Cisco-Offensive-Summit/badge-2026/hardware/readme.md

## 2026 Offensive Summit Badge hardware files

[PCB Schematic](https://github.com/Cisco-Offensive-Summit/badge-2026/blob/main/hardware/OS-2026-Badge-Schematic-REV1.pdf)  
[PCB Assembly Document](https://github.com/Cisco-Offensive-Summit/badge-2026/blob/main/hardware/2026-Badge-Assembly-REV1.PDF)   
[PCB Fabrication Drawing](https://github.com/Cisco-Offensive-Summit/badge-2026/blob/main/hardware/2026-Badge-Fabdrawing-REV1.PDF)  

[PCB Bill of Materials](https://github.com/Cisco-Offensive-Summit/badge-2026/blob/main/hardware/2026-Badge-BOM-REV1.xls)  
[Final Assembly Bill of Materials](https://github.com/Cisco-Offensive-Summit/badge-2026/blob/main/hardware/2026-Badge-Final-Assembly-BOM.xlsx)  

[PCB Fabrication Data](https://github.com/Cisco-Offensive-Summit/badge-2026/blob/main/hardware/2026-Badge-REV1.zip)   

[2D Front Side Image](https://github.com/Cisco-Offensive-Summit/badge-2026/blob/main/hardware/2026-Badge-2D-Front.PNG)  
[2D Back Side Image](https://github.com/Cisco-Offensive-Summit/badge-2026/blob/main/hardware/2026-Badge-2D-Back.PNG)  

[3D Front Side Image](https://github.com/Cisco-Offensive-Summit/badge-2026/blob/main/hardware/2026-Badge-3D-Front.PNG)  
[3D Back Side Image](https://github.com/Cisco-Offensive-Summit/badge-2026/blob/main/hardware/2026-Badge-3D-Back.PNG)  

[Assembled PCB Front Side Photo](https://github.com/Cisco-Offensive-Summit/badge-2026/blob/main/hardware/os-badge-2026-front-assembled.png)  
[Assembled PCB Back Side Photo](https://github.com/Cisco-Offensive-Summit/badge-2026/blob/main/hardware/os-badge-2026-back-assembled.png)  

## Screens
[P3 E2271KSOC1 ePaper 2.71" TFT EPD](https://www.mouser.in/en/ProductDetail/Pervasive-Displays/E2271KS0C1?qs=ZcfC38r4PouNwoyWKev%252BKw%3D%3D)  
[P2 TFT RGB 1.44"](https://www.digikey.in/en/products/detail/orient-display/AFL128128A0-1-44N12NTM-ANO/22531958)  

## Addressable LEDs
[Neopixel LED D5,D6,D7,D8](https://www.digikey.in/en/products/detail/adafruit-industries-llc/1938/6827082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)
