Cisco-Offensive-Summit/badge-2026/arduino/readme.md

Setup of Arduino Environment:  
Arduino --> Settings --> Additional boards manager URLs: https://espressif.github.io/arduino-esp32/package_esp32_index.json  
Tools --> Board --> Boards Manager --> esp32 by Espressif Systems (install)  
Tools --> Board --> esp32 --> ESP32S3 DEV Module   
Port: "/dev/cu.usbmodemXXXXX"  
USB CDC On Boot: Enabled  
CPU Frequency "240MHz (WiFi)"  
Core Debug Level: "Warn"  
USB DFU On Boot: "Disabled"  
Erase All Flash Before Sketch Upload: "Enabled"  
Events Run On: "Core 1"  
Flash Mode: "QIO 80MHz"  
Flash Size: "16MB (128Mb)"  
JTAG Adapter: "Disabled"  
Arduino Runs On: "Core 1"  
USB Firmware MSC On Boot: "Disabled"  
Partition Scheme: "Minimal(1.3MB APP/700KB SPIFFS)"  
PSRAM: "Disabled"  
Upload Mode: "UART0/Hardware CDC"  
Upload Speed "115200"  
USB Mode "Hardware CDC and JTAG"  
Zigbee Mode: "Disabled"  
Programmer "Esptool"  

Be sure to install the Libraries!!! 
(Tools --> Manage Libraries --> )
Adafruit_BusIO  
Adafruit_ST7735_and_ST7789_Library  
FastLED  
Adafruit_GFX_Library  
PDLS_BASIC  
PDLS_Common  
Pervasive_Wide_Small
