Cisco-Offensive-Summit/badge-2026/docs/HW-VIllage-2026-Presentation.pdf

## HARDWARE VILLAGE 2026

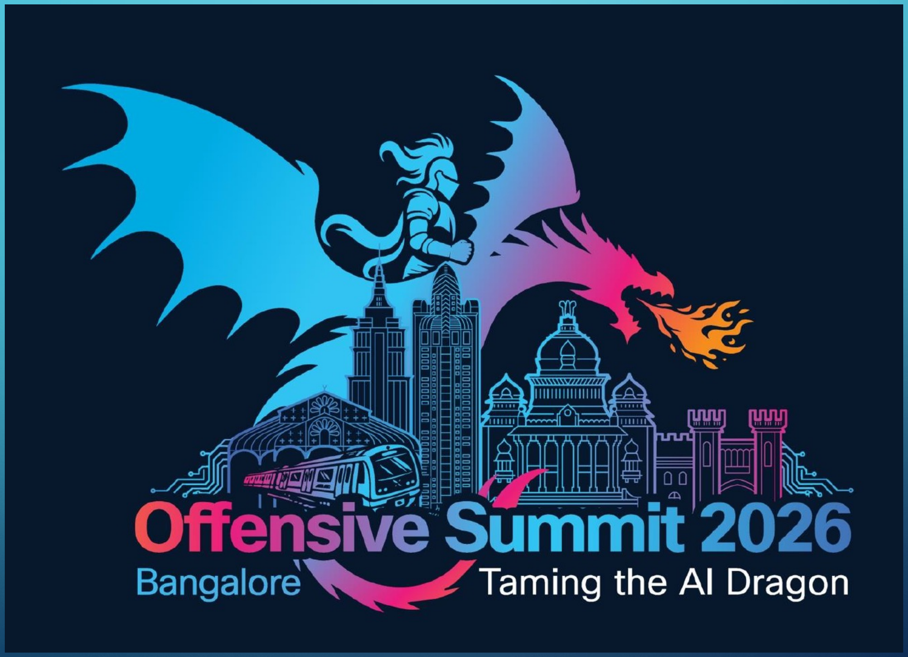
[picture p1: figure]

## OFFENSIVE SUMMIT BADGE 2026

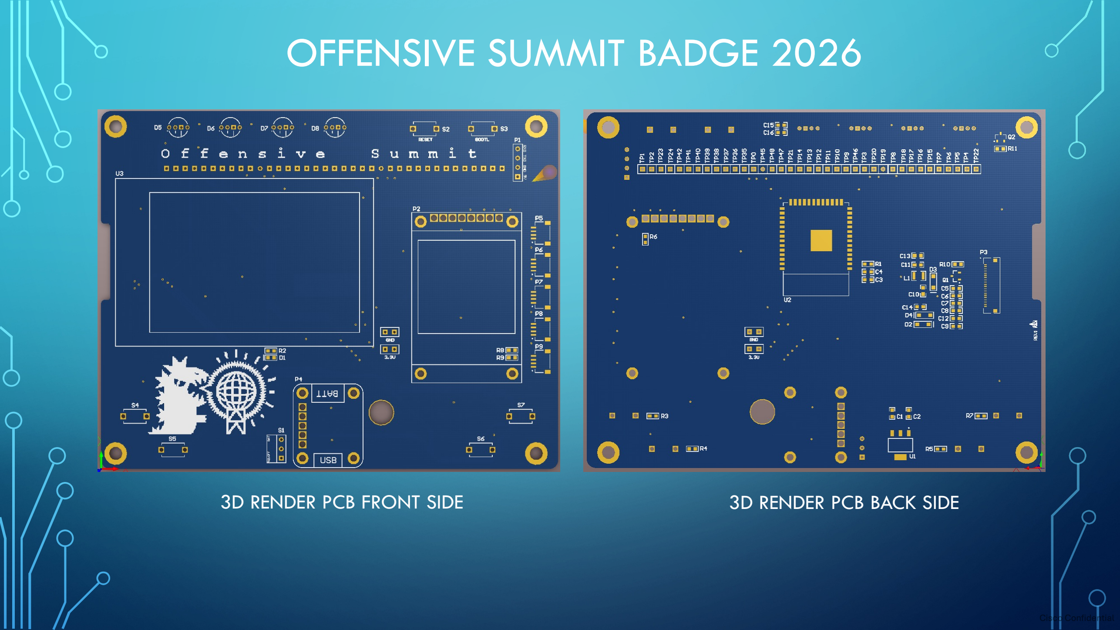
[picture p2: page 2]

3D RENDER PCB FRONT SIDE | 3D RENDER PCB BACK SIDE

## OFFENSIVE SUMMIT BADGE 2026

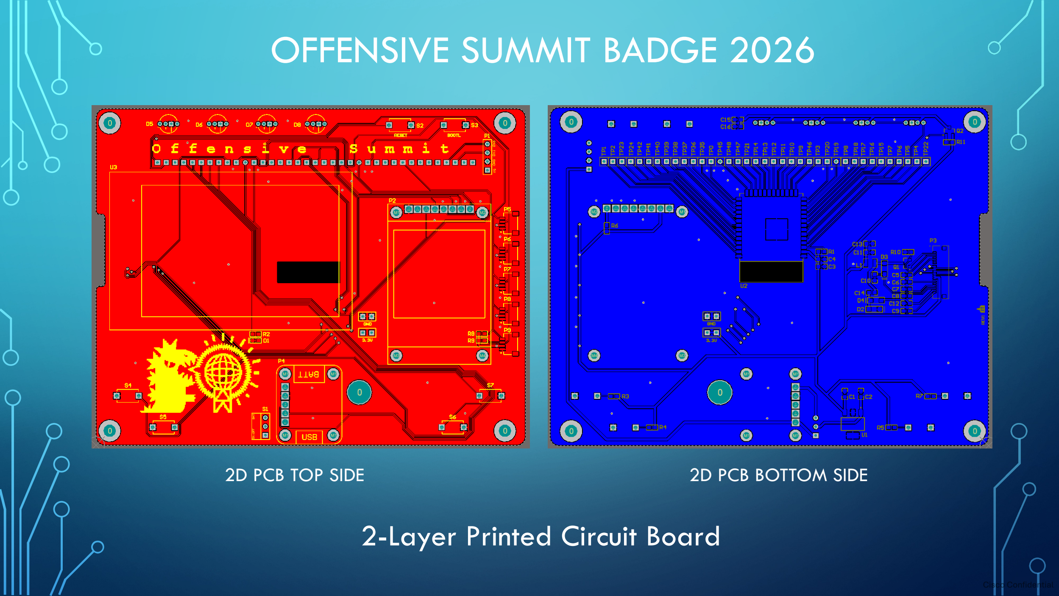
[picture p3: page 3]

2D PCB TOP SIDE | 2D PCB BOTTOM SIDE
2-Layer Printed Circuit Board

## OFFENSIVE SUMMIT BADGE 2026

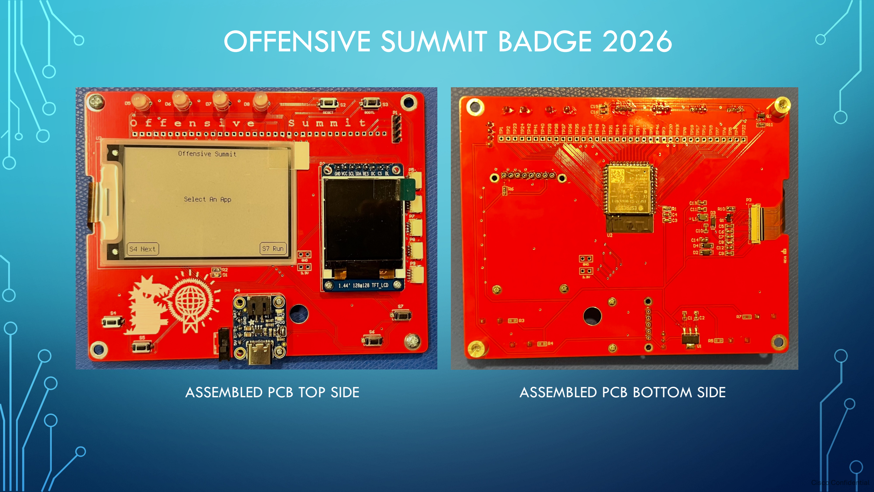
[picture p4: page 4]

ASSEMBLED PCB TOP SIDE | ASSEMBLED PCB BOTTOM SIDE

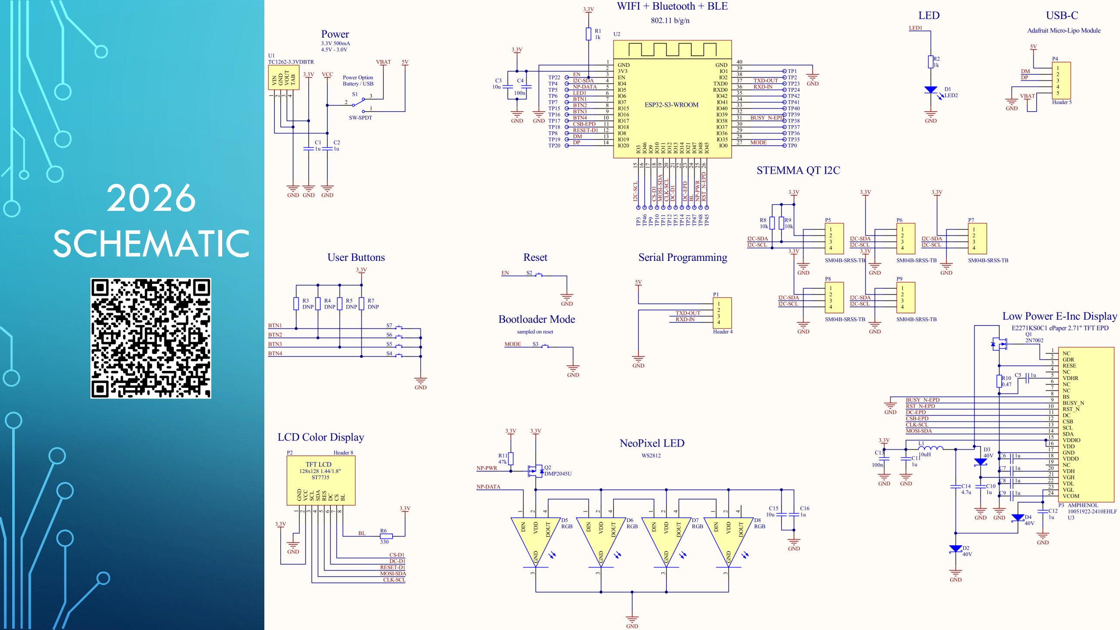
[picture p5: page 5]

2026

## SCHEMATIC

## 2026 BADGE PCB FEATURES

- ESP32-S3 WROOM Processor
- Bluetooth, Wifi, 802.11 b/g/n
- Dual LX7, 240 MHz, 16MB flash
- 2.71” Low Power E-Inc ePaper Display
- 1.44” 128x128 TFT LCD Color Display
- 4x NeoPixel WS2812 addressable LEDs
- 1x General Purpose LED
- 4x Hard buttons
- 5x STEMMA QT/Qwiic headers
- I2C module expansion

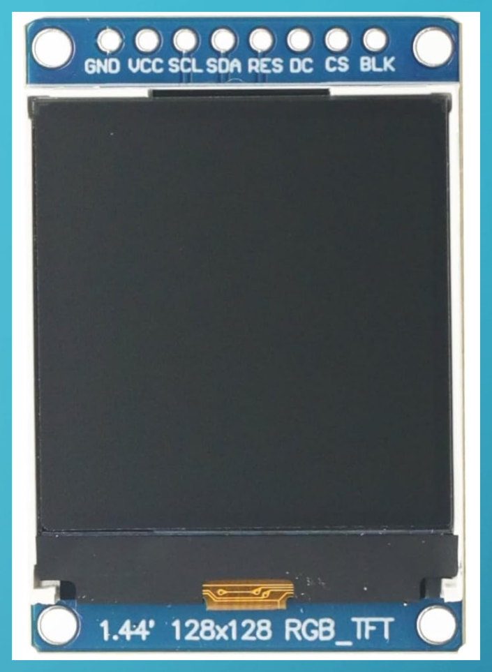
[picture p6: figure]

1.44” TFT LCD

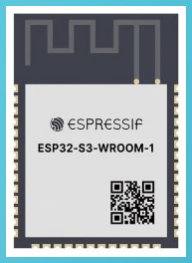
[picture p7: figure]

ESP32

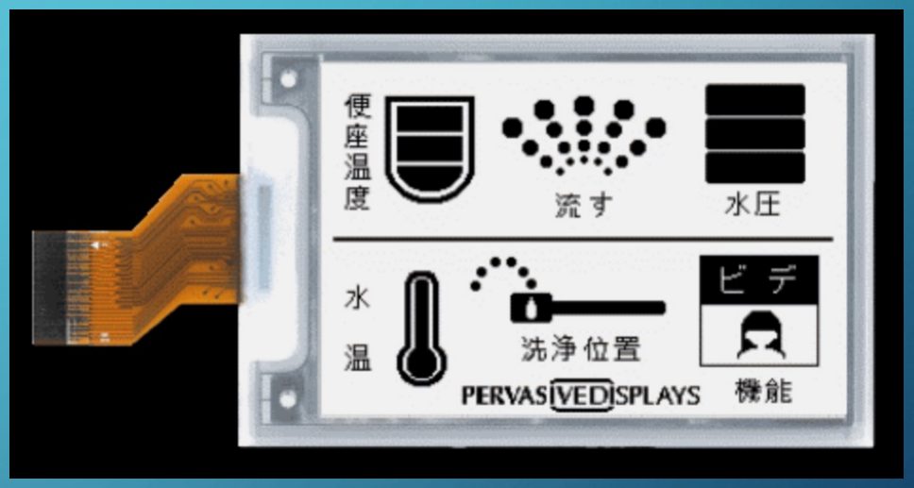
[picture p8: figure]

2.71” ePaper

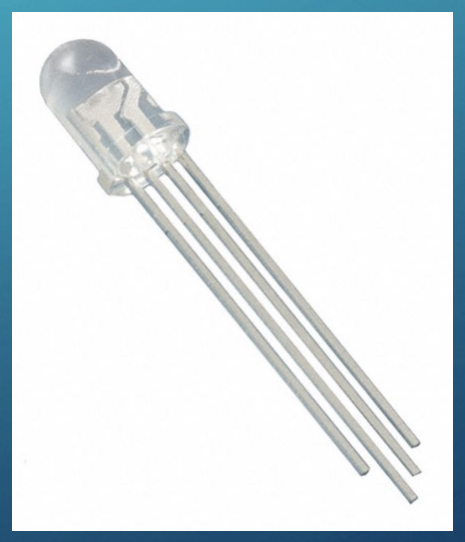
[picture p9: figure]
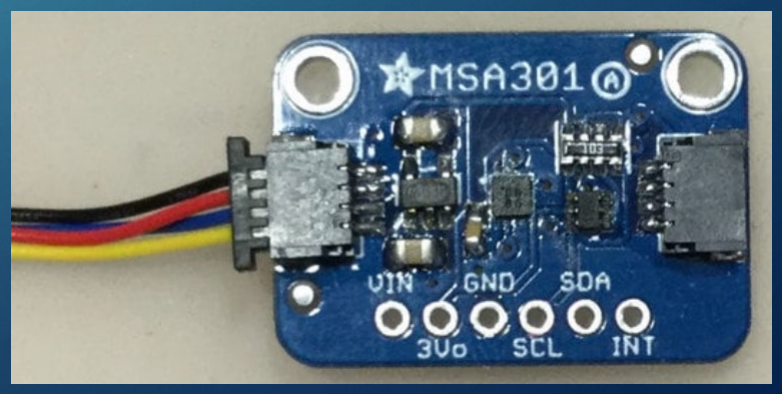
[picture p10: figure]

NeoPixel | Stemma Module

## STEMMA/QWIIC EXPANSION MODULES

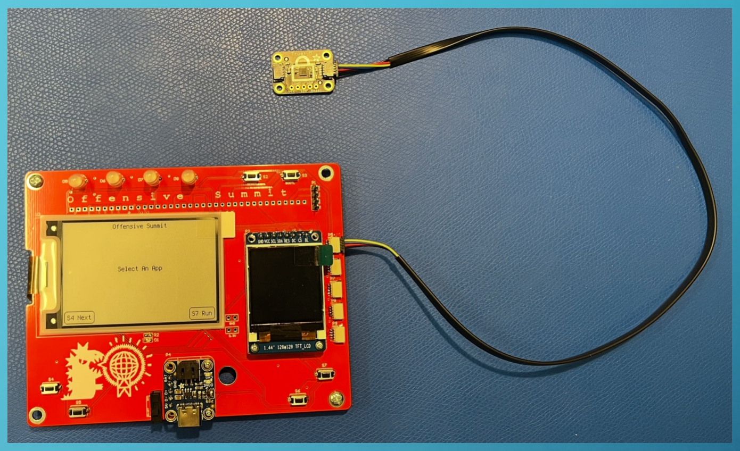
[picture p11: figure]

- 14 Segment Display
- Arduino Modulino Buzzer
- Light Sensor
- IR Remote Transceiver
- Tiny Code Reader
- 3 Axis Accelerometer
- QWIIC Joystick
- Humidity and Temperature Sensor
- Real Time Clock
- Power Monitor
- Proximity Sensor

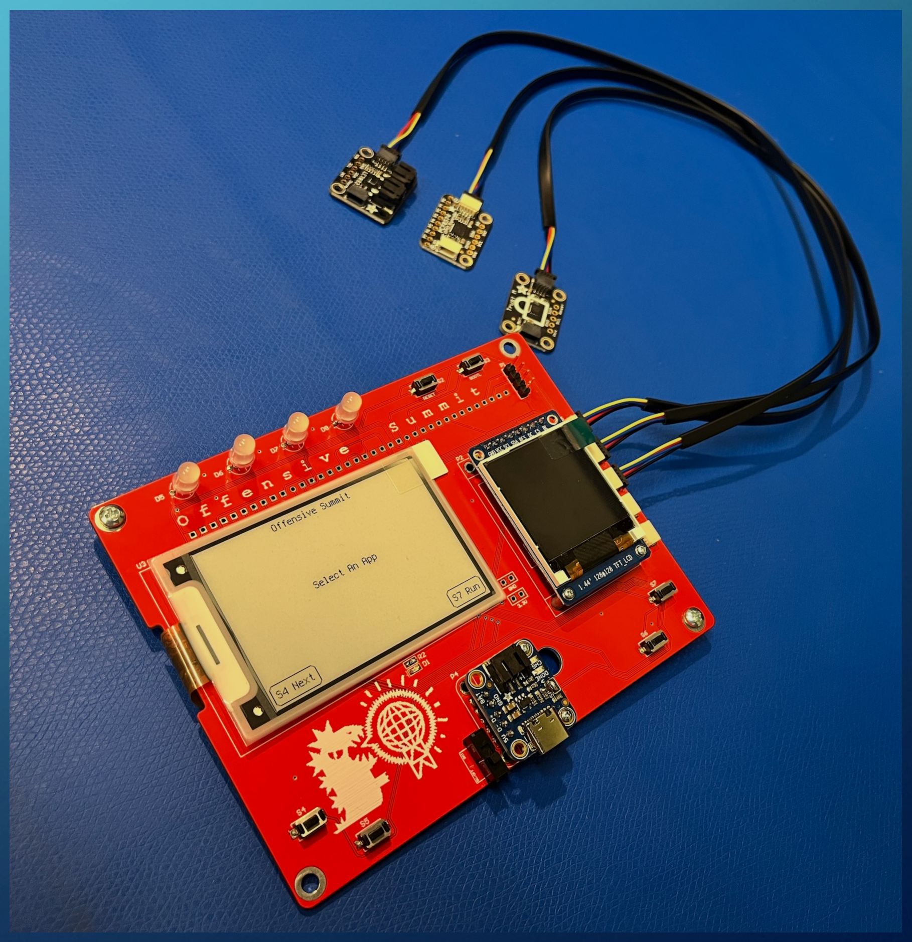
[picture p12: figure]

## HARDWARE VILLAGE CONTESTS!!

- The Hardware Village runs a series of engineering challenges during the event.
- Each award goes to the first attendee to successfully assemble and demonstrate the specified capability.
- Show your working badge to a Hardware Village mentor to claim.

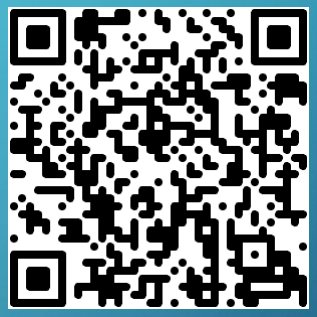
[picture p13: figure]

Hardware Village Contests

https://scripts.cisco.com/app/os_badge_2026/#/leaderboard

## OS 2026 BADGE SOFTWARE & LINKS

- #badgelife - https://scripts.cisco.com/app/os_badge_2026/#/
- 2026 Wiki - https://github.com/Cisco-Offensive-Summit/badge-2026/wiki
- 2026 github - https://github.com/Cisco-Offensive-Summit/badge-2026/tree/main
#badgelife | wiki | github

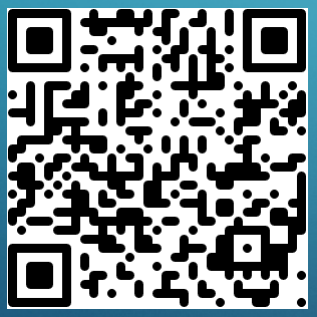
[picture p14: figure]
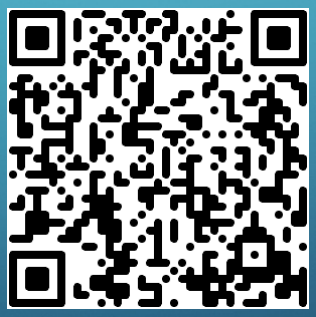
[picture p15: figure]
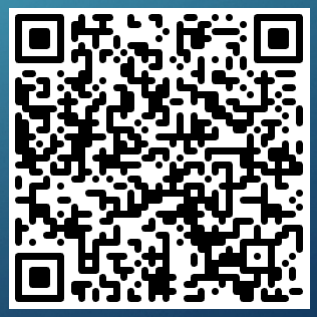
[picture p16: figure]

## ESP32 S3 GENERIC PROGRAMING GUIDES

- ESP-IDF - https://developer.espressif.com/tags/esp-idf/
- Python - https://micropython.org/download/ESP32_GENERIC_S3/
- Arduino - https://docs.espressif.com/projects/arduino-esp32/en/latest/getting_started.html
ESP-IDF | #Python | Arduino

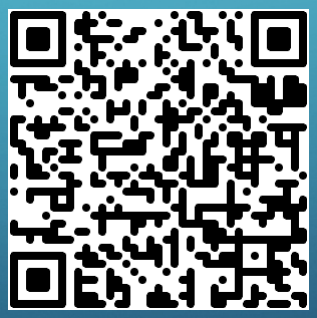
[picture p17: figure]
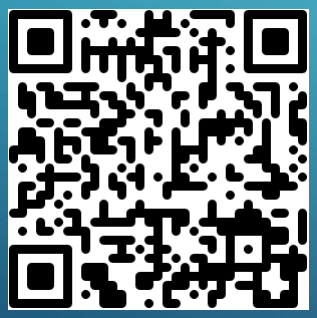
[picture p18: figure]
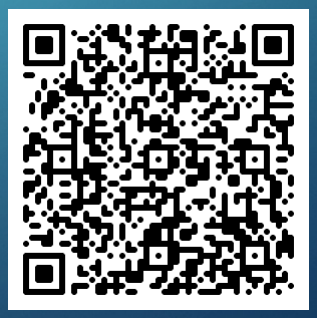
[picture p19: figure]

## OS HARDWARE VILLAGE 2026 - LEARN TO SOLDER!!

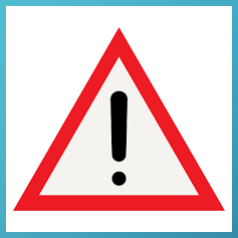
[picture p20: figure]
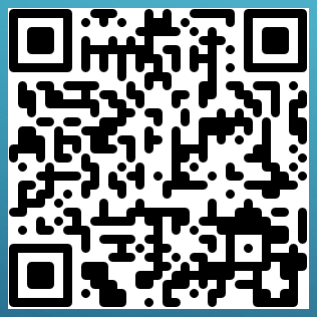
[picture p21: figure]
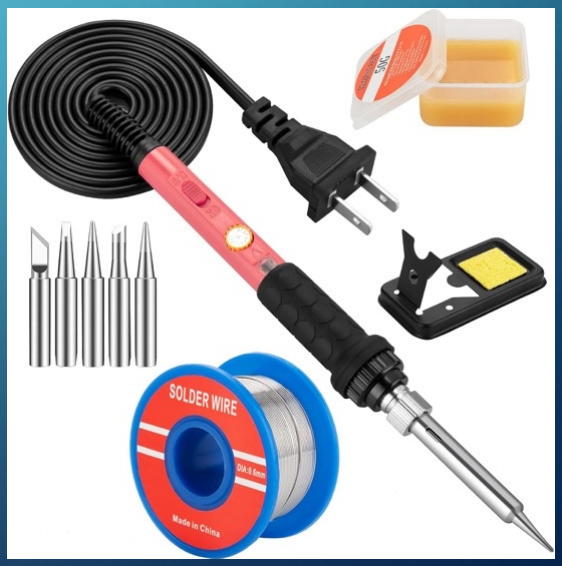
[picture p22: figure]

- REQUIRED (15 minute) training for all employees
who perform soldering activities!!!
- https://learn.cisco.com/?courseId=COT00237304

Solder Training

## USB REMOVABLE MEDIA

- the use of removable media storage devices on Cisco-managed Windows, MacOS and Linux devices is now restricted
- The 'Removable Media/USB Exception form' can be
submitted (manager approval required)

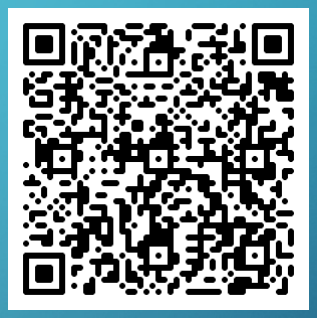
[picture p23: figure]

Removable Media/USB Exception

https://cisco.service-now.com/helpzone?id=kb_article&sysparm_article=KB0069044

## A SPECIAL THANK YOU TO THE 2026 BADGE TEAM!!

- Everett Stiles (evstiles)
- Phillip McKnight (phimckni)
- Sam Maclean (samaclea)
- Fabs Haas (fahaas)
- Marcin Wojcik (mawojcik)
- Daniel Starnowski (dstarnow)
- Jed Eaton (jedeaton)
- Joe Gipson (jogibson)
- Harikrishnan Jayachandran (hjayacha)
- Anupam Pavithran (anpavith)

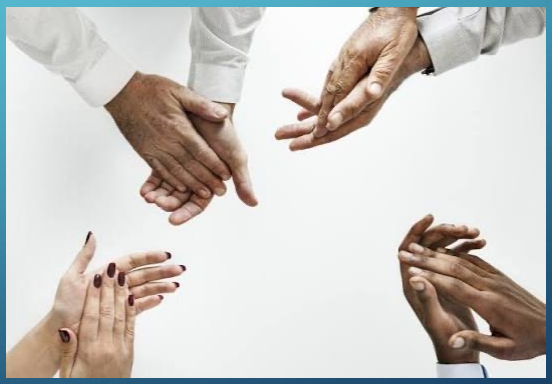
[picture p24: figure]
