Cisco-Offensive-Summit/badge-2026/src/apps/sequencer/sequencer.bmp

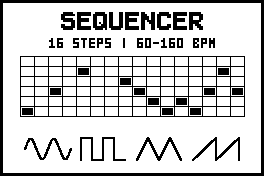
src/apps/sequencer/sequencer.bmp
