Cisco-Offensive-Summit/badge-2026/src/apps/storage/storage_bg.bmp

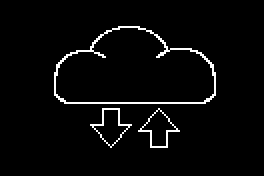
src/apps/storage/storage_bg.bmp
