Cisco-Offensive-Summit/badge-2026/src/apps/totris/img/totris.bmp

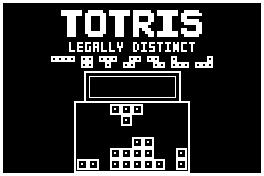
src/apps/totris/img/totris.bmp
