Cisco-Offensive-Summit/badge-2026/hardware/2026-Badge-BOM-REV1.xls

Designator | Description | Manufacturer | Manufacturer Part Number | Distributor | Distributor Part Number | MFG-Comment | Quantity
C1, C2, C5, C6, C7, C8, C9, C10, C11, C12, C16 | CAP CER 1UF 50V X5R 0603 | TDK Corporation | CGA3E3X5R1H105M080AB | DigiKey | 445-12510-1-ND |  | 11
C14 | CAP CER 4.7UF 10V X5R 0603 | Samsung Electro-Mechanics | CL10A475KP8NNNC | DigiKey | 1276-1044-1-ND |  | 1
C3, C15 | CAP CER 10UF 10V X7T 0603 | Murata Electronics North America | GRM188D71A106KA73D | DigiKey | 490-14461-1-ND |  | 2
C4, C13 | CAP CER .1UF 10V X7R 0603 | Wurth Electronics Inc. | 885012206020 | DigiKey | 732-7939-1-ND |  | 2
D1 | LED ORANGE CLEAR CHIP SMD | Kingbright | AOT1608SECK | DigiKey | 754-1120-1-ND |  | 1
R1, R2 | RES SMD 1K OHM 5% 1/10W 0603 | Yageo | RC0603JR-071KL | DigiKey | 311-1.0KGRCT-ND |  | 2
R10 | RES 0.47 OHM 5% 1/10W 0603 | CTS Resistor Products | 73L2R47J | DigiKey | 60-73L2R47JCT-ND |  | 1
R11 | RES SMD 47K OHM 5% 1/10W 0603 | Yageo | RC0603JR-0747KL | DigiKey | 311-47KGRCT-ND |  | 1
R6 | RES SMD 330 OHM 5% 1/10W 0603 | Yageo | RC0603JR-07330RL | DigiKey | 311-330GRCT-ND |  | 1
R8, R9 | RES SMD 10K OHM 5% 1/10W 0603 | Yageo | RC0603JR-0710KL | DigiKey | 311-10KGRCT-ND |  | 2
P3 | CONN FPC BOT 24POS 0.5MM R/A | Amphenol ICC (FCI) | 10051922-2410EHLF | DigiKey | 609-6433-1-ND |  | 1
D5, D6, D7, D8 | ADDRESS LED DISCR SERIAL RGB | Spark Fun | COM-12986 | DigiKey | 1568-1213-ND | 1568-1213-ND contains 5 each of COM-129865 | 1
U2 | Bluetooth, WiFi 802.11b/g/n, Bluetooth v5.0 Transceiver Module 2.4GHz PCB Trace Surface Mount | Espressif Systems | ESP32-S3-WROOM-1-N16R8 | DigiKey | 1965-ESP32-S3-WROOM-1-N16R8TR-ND | No Solder paste on large GND pad | 1
S1 | SWITCH SLIDE SPDT 200MA 30V | E-Switch | EG1218 | DigiKey | EG1903-ND |  | 1
P1 | Header, 4-Pin | Wurth Elektronik | 61300411121 | DigiKey | 732-5317-ND |  | 1
S2, S3, S4, S5, S6, S7 | Tactile Switch SPST-NO Top Actuated Through Hole | C&K | PTS636 SL43 LFS | DigiKey | CKN12301-ND |  | 6
L1 | FIXED IND 10UH 900MA 408 MOHM | Delta Electronics / Cyntec | SDET25201B-100MS | DigiKey | 2037-SDET25201B-100MSCT-ND |  | 1
P5, P6, P7, P8, P9 | CONN HEADER SMD R/A 4POS 1MM | JST Sales America Inc. | SM04B-SRSS-TB | DigiKey | 455-SM04B-SRSS-TBCT-ND |  | 5
D2, D3, D4 | DIODE SCHOTTKY 40V 2A SOD123FL | Panjit International Inc. | SS2040FL_R1_00001 | DigiKey | 3757-SS2040FL_R1_00001CT-ND |  | 3
Q1 | MOSFET N-CH 60V 280MA SOT23-3 | Diotec Semiconductor | 2N7002 | DigiKey | 4878-2N7002CT-ND |  | 1
Q2 | P-Channel Power MOSFET | Diodes Incorporated | DMP2045U-7 | DigiKey | DMP2045U-7DICT-ND |  | 1
U1 | IC REG LINEAR 3.3V 500mA SOT223-3 | Microchip Technology | TC1262-3.3VDBTR | DigiKey | TC1262-3.3VDBCT-ND |  | 1
3.3V, 3.3V, GND, GND, R3, R4, R5, R7, TP0, TP1, TP2, TP3, TP4, TP5, TP6, TP7, TP8, TP9, TP10, TP11, TP12, TP13, TP14, TP15, TP16, TP17, TP18, TP19, TP20, TP21, TP22, TP23, TP24, TP35, TP36, TP37, TP38, TP39, TP40, TP41, TP42, TP45, TP46, TP47, TP48, U3 | DO NOT POPULATE | NONE | NONE | NONE | NONE | DO NOT POPULATE | 46
P2, P4 | 1.44" 128x128 65K SPI Full Color TFT LCD Display Module ST7735 OLED for Arduino, Adafruit Micro-Lipo Charger for LiPoly Batt with USB Type C Jack | Mill-Max | 7406-0-15-15-18-27-10-0 | DigiKey | ED90446-ND | 8 each for P2, 5 each for P5 | 13
