Cisco-Offensive-Summit/badge-2026/hardware/2026-Badge-Final-Assembly-BOM.xlsx

Designator | Description | Manufacturer | Manufacturer Part Number | Distributor | Distributor Part Number | MFG-Comment | Quantity
P2 Screen | 1.44 Inch TFT LCD 65K Color 128x128 Display Screen SPI Serial Port Module ST7735 | DIY MORE ALICE 11019873 Store | 2251832827962911 | Ali Express | 2251832827962911 | https://www.aliexpress.com/store/1101203370 | 1
P3/U3 Screen | Electronic Paper Displays - ePaper 2.71" EPD, Wide Temp., B/W, Fast update | Pervasive Displays | E2271KS0C1 | Mouser | 341-E2271KS0C1 |  | 1
P5 Module | Adafruit Micro-Lipo Charger for LiPoly Batt with USB Type C Jack | Adafruit Industries LLC | 4410 | Digikey | 1528-4410-ND |  | 1
P5 Battery | BATTERY LITH-ION 3.7V 400MAH | SparkFun Electronics | 13851 | Digikey | 1568-13851-ND | position battery on PCB Bottom side, connect to Micro Lipo Charger Module through the PCB thruhole above P5 | 1
PCB Standoff | Female Threaded Round Standoff - 1/4" OD, 1/4" Long, 4-40 Thread Size | McMaster Carr | 93330A431 | McMaster Carr | 93330A431 | PCB bottom side, connect to backing plate | 4
PCB Standoff Screw | Pan Head Phillips Screw - 4-40 Thread, 3/16" Long | McMaster Carr | 90272A105 | McMaster Carr | 90272A105 |  | 8
P2, P5 Standoff | Female Threaded Round Standoff, 1/8" OD, 1/4" Long, 0-80 Thread Size | McMaster Carr | 93330A211 | McMaster Carr | 93330A211 | PCB top side, connect to P2 LCD Display | 8
P2, P5 Standoff Screw | Pan Head Phillips Screw 0-80 Thread, 3/16" Long | McMaster Carr | 90272A025 | McMaster Carr | 90272A025 |  | 16
U3 Screen and P5 Battery Adhesive mounting pad | 27 x 27 x 2mm Adhesive Foam Pad Mounting Squares | YGPHO | 717378795550 | Amazon | B0CCS3CSC3 | position U3 adhesive pad on PCB topside, position P5 battery adhesive pad on PCB bottom side, https://www.amazon.com/500Pcs-Super-Sticky-Self-Adhesive-Mounting-Mirrors/dp/B0CCS3CSC3 | 2
