Cisco-Offensive-Summit/badge-2026/hardware/OS-2026-Badge-Schematic-REV1.pdf

# Power

## 802.11 b/g/n

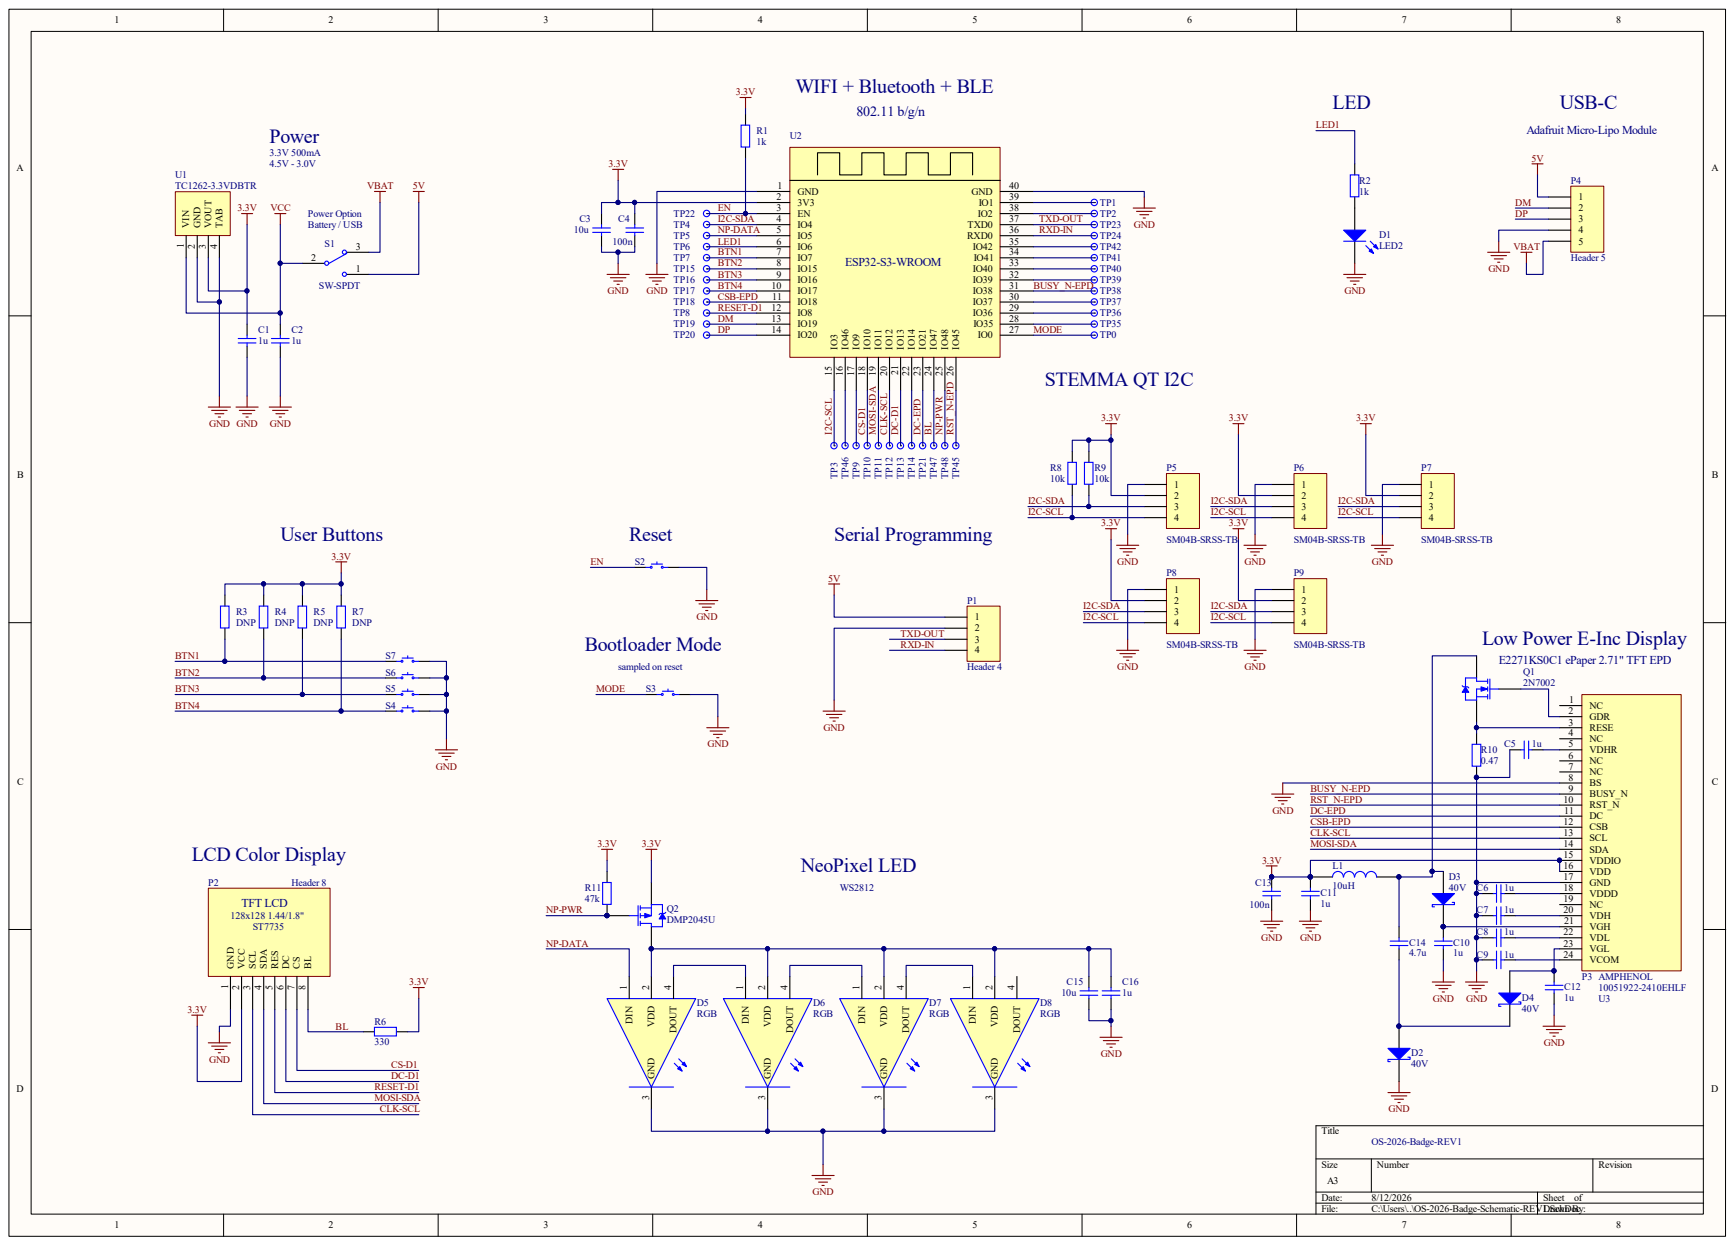
[picture p28: page 1]

Adafruit Micro-Lipo Module

TP24 TP³ TP⁴⁶ TP⁹ TP¹⁰ TP¹¹ TP¹² TP¹³ TP¹⁴ TP²¹ TP⁴⁷ TP⁴⁸ TP⁴⁵

GND NP⁻PWR RST_N⁻EPD
GND DC⁻EPD

Low Power E-Inc Display
