Cisco-Offensive-Summit/badge-2026/hardware/2026-Badge-Assembly-REV1.PDF

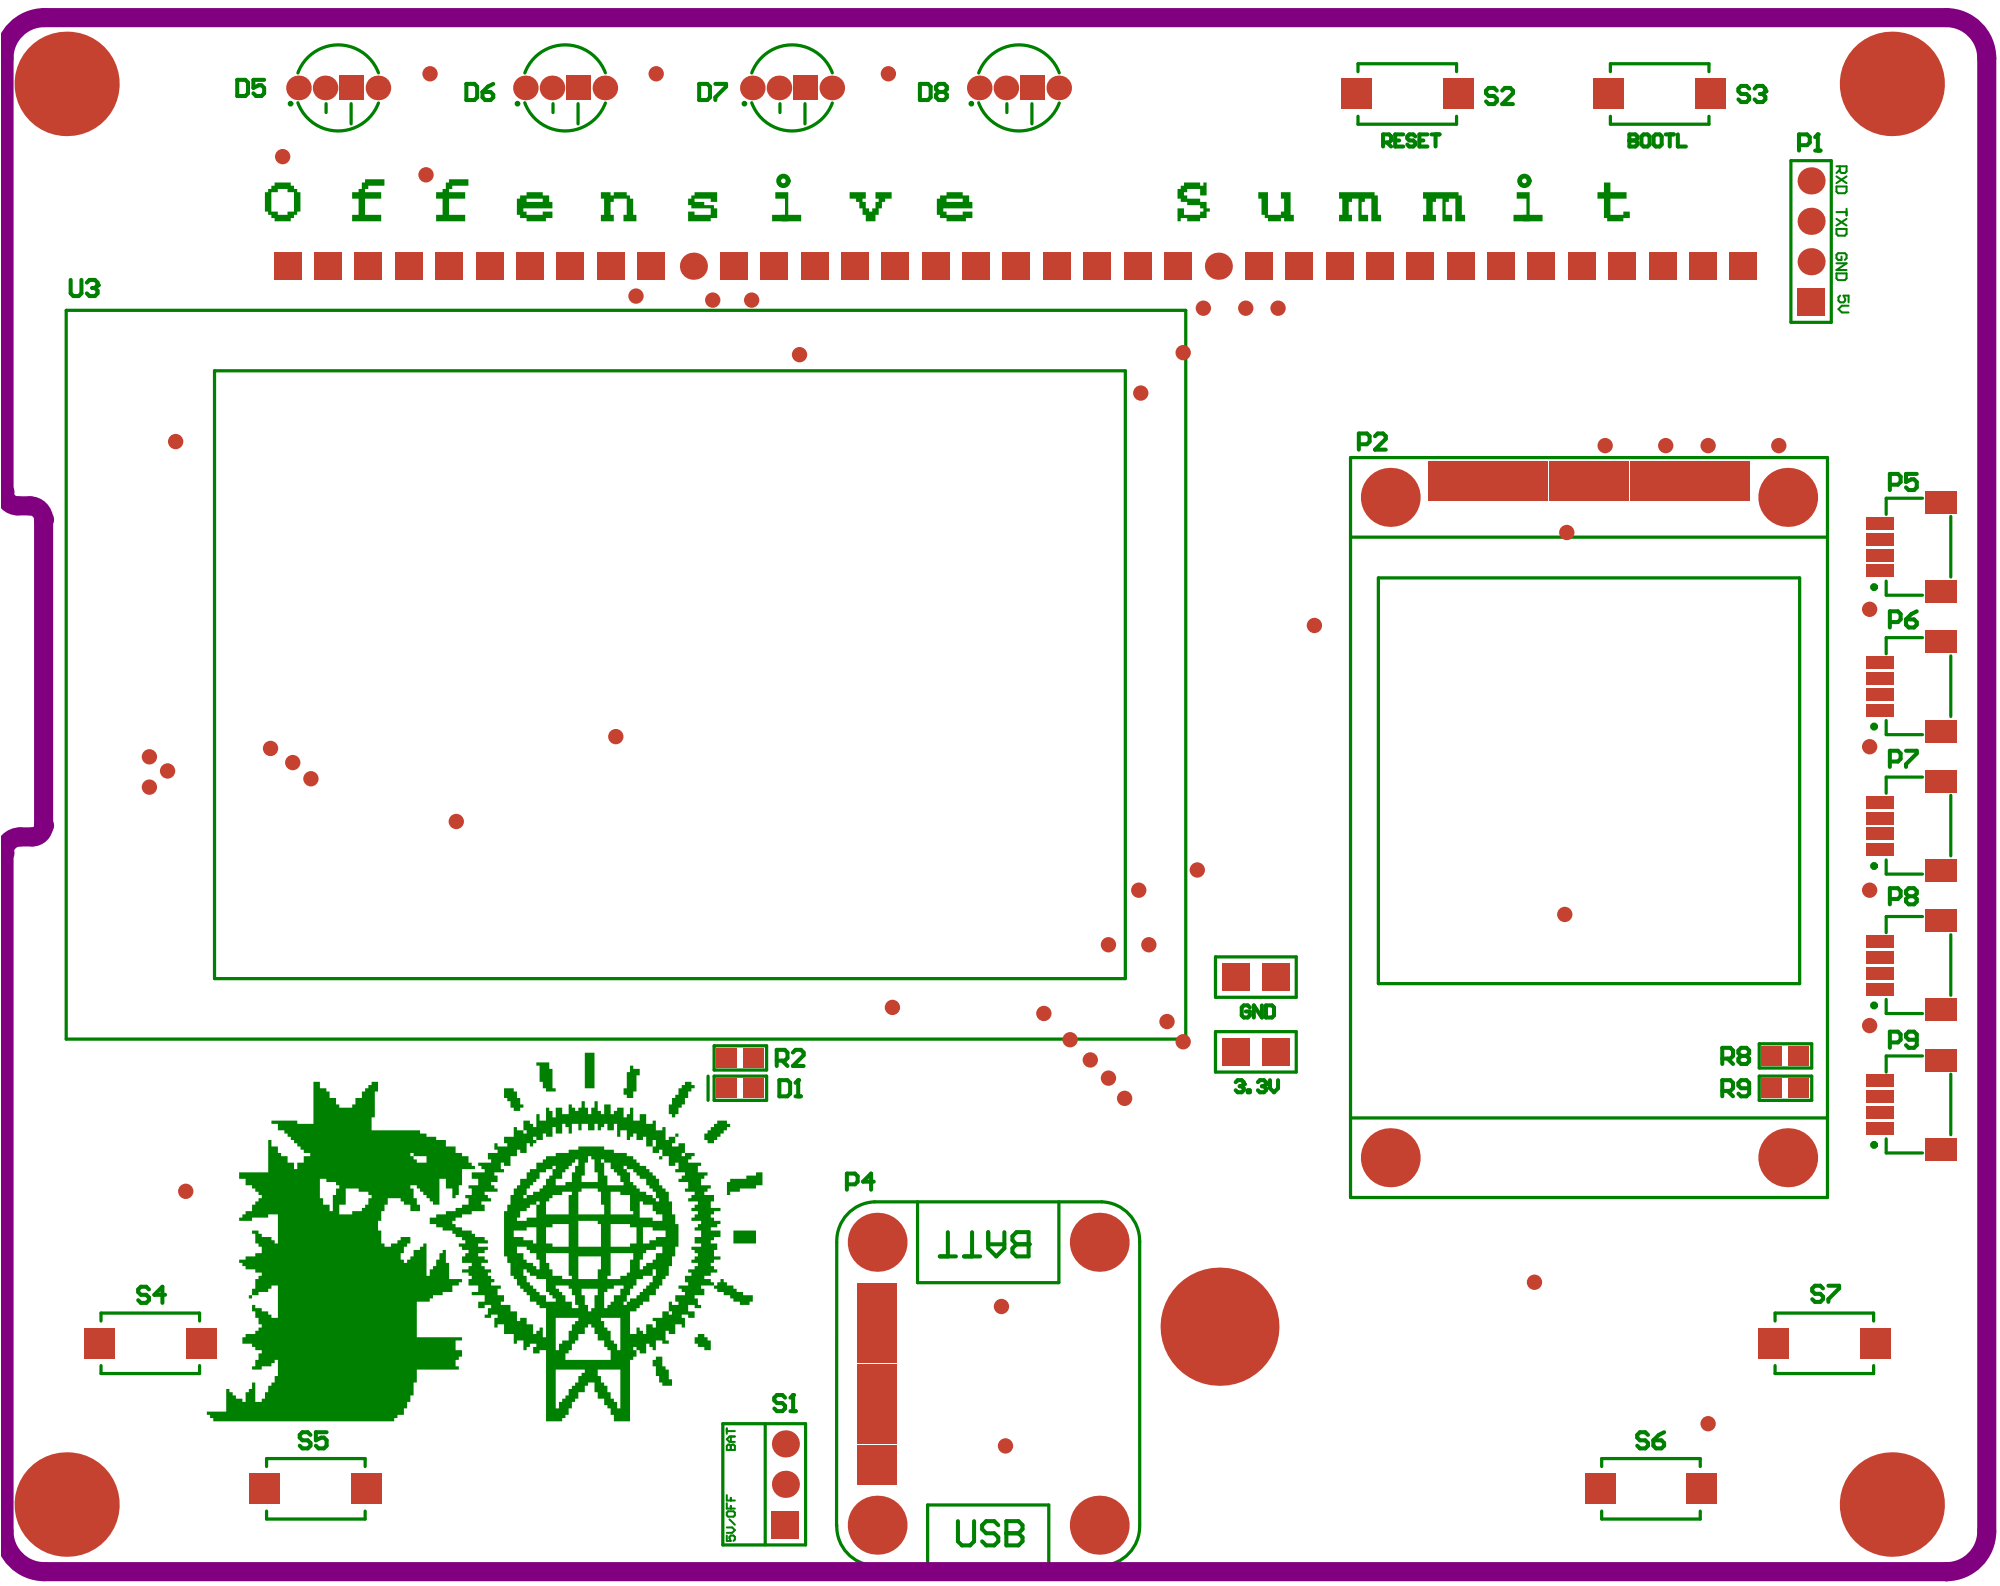
[picture p29: page 1]

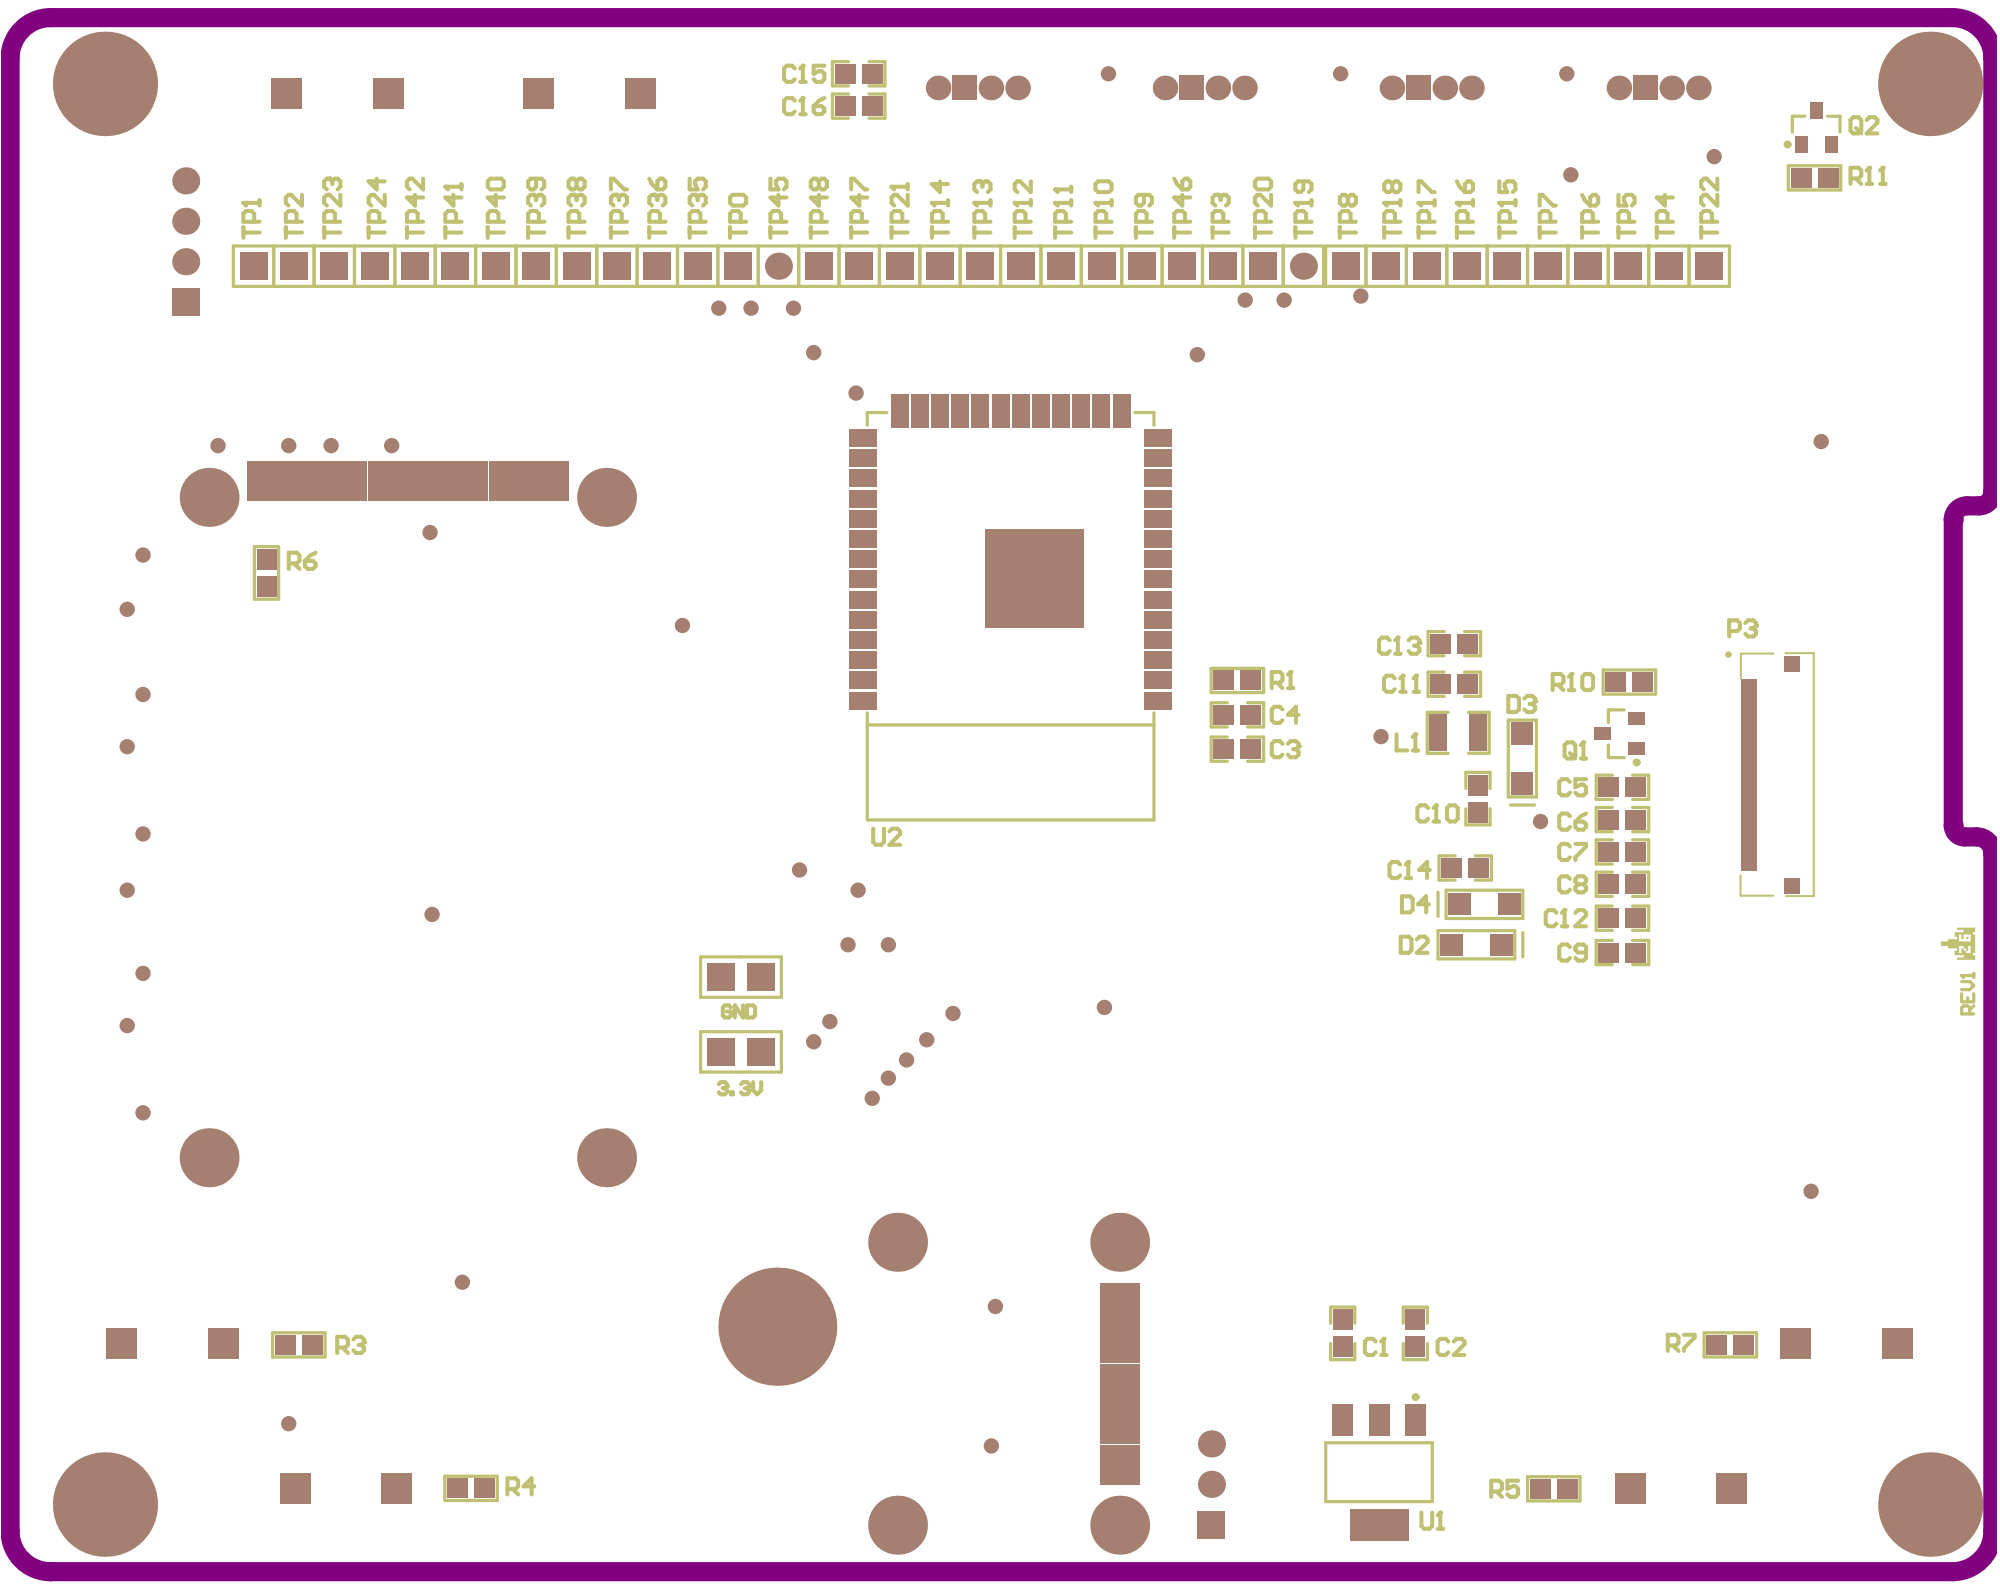
[picture p30: page 2]
