Cisco-Offensive-Summit/badge-2026/hardware/2026-Badge-Fabdrawing-REV1.PDF

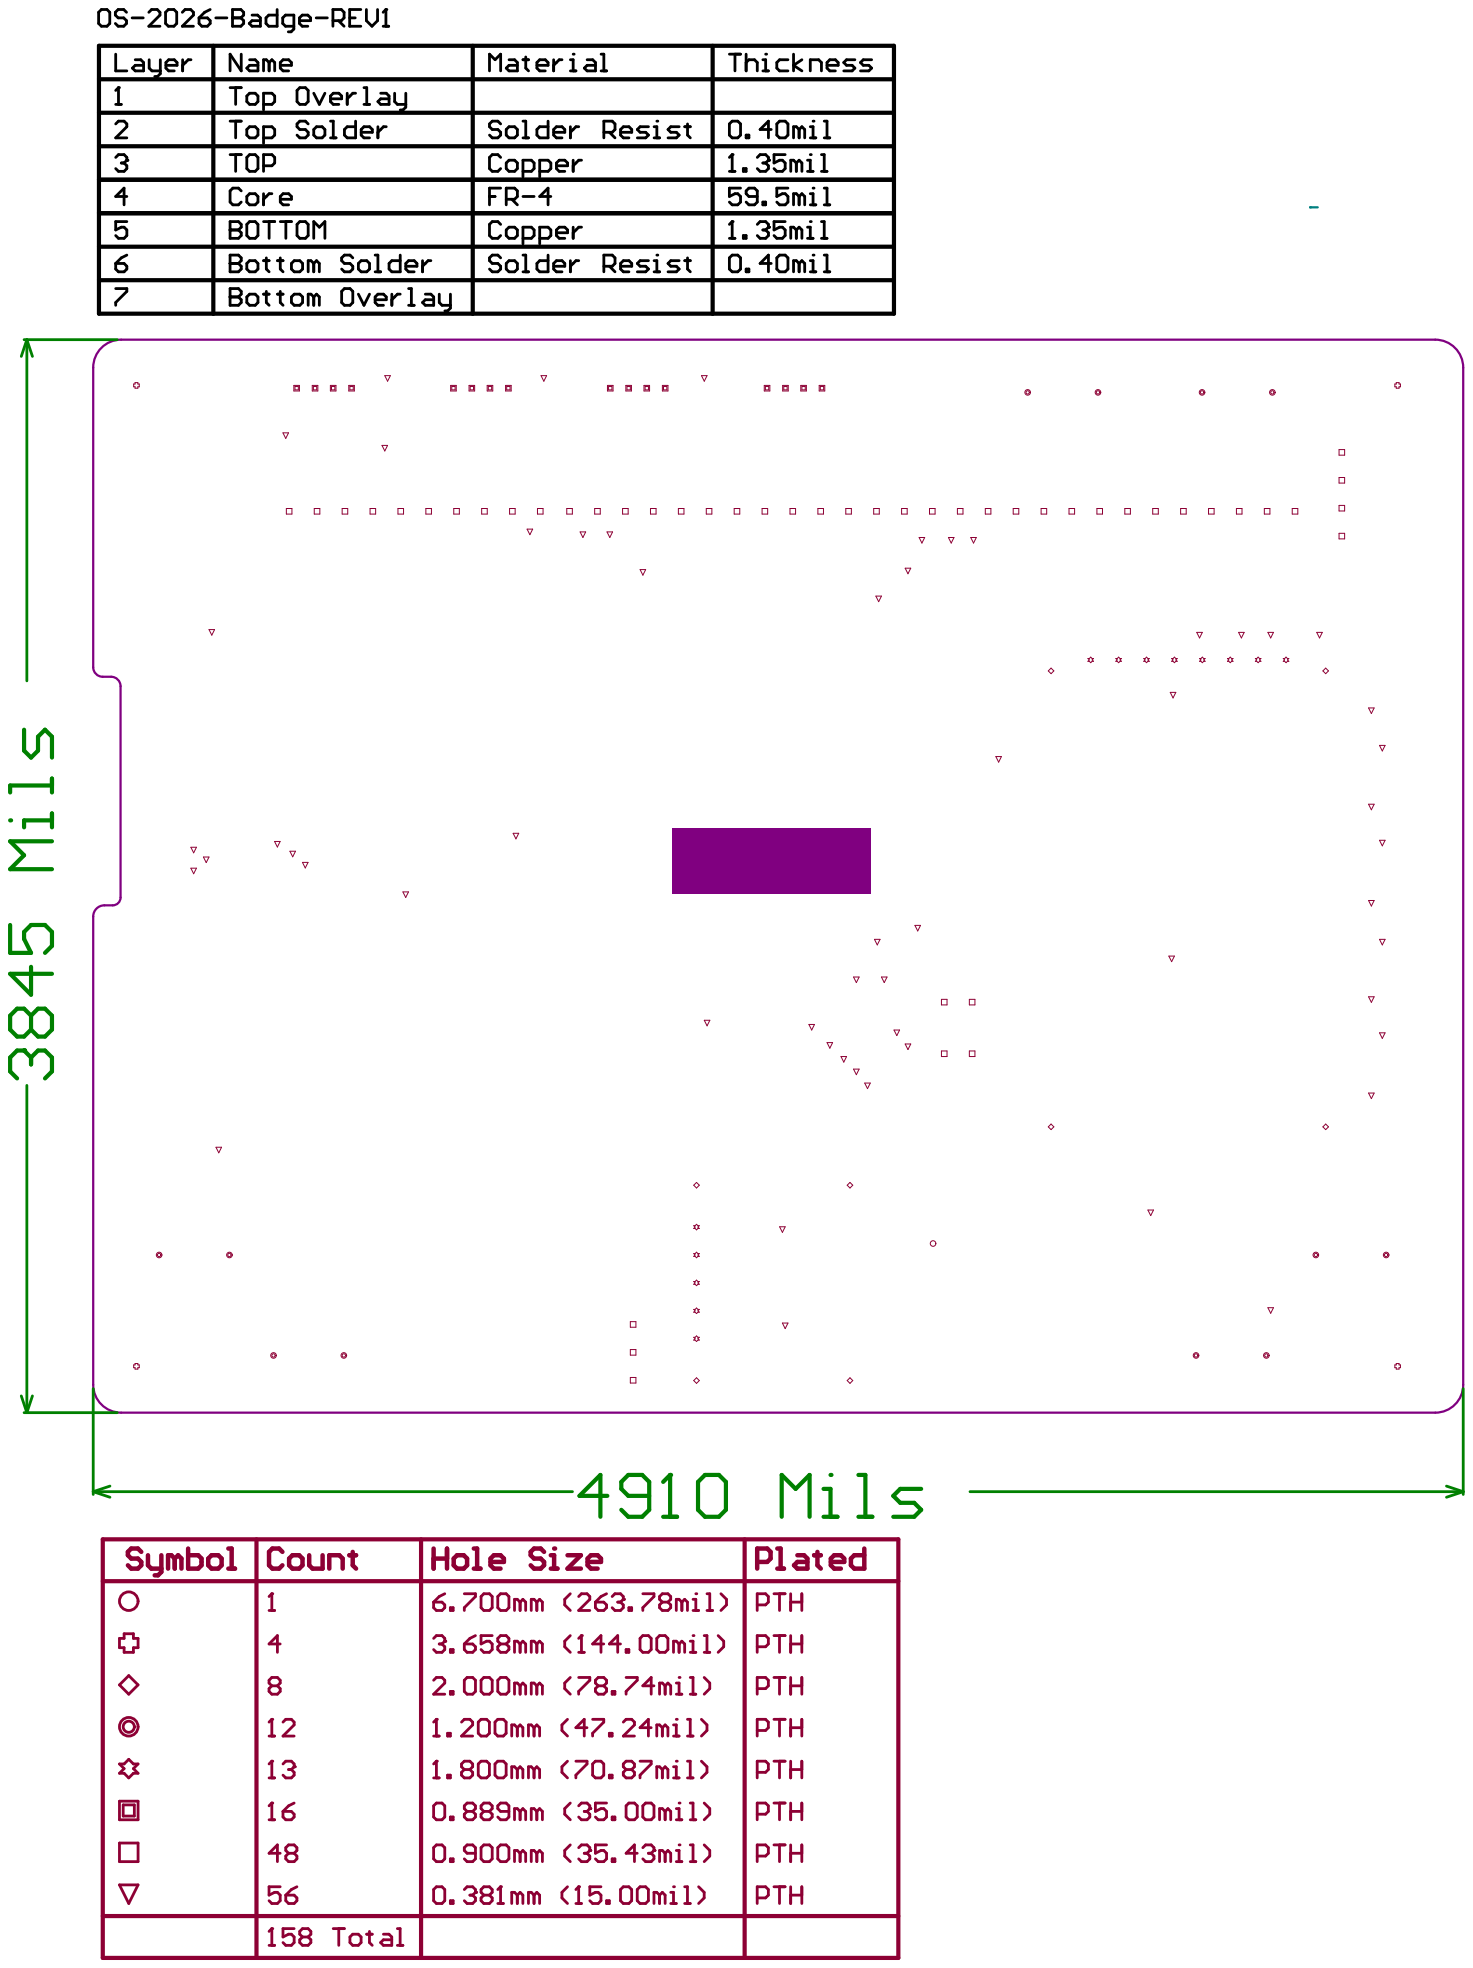
[picture p31: page 1]
