Cisco-Offensive-Summit/badge-2026/src/apps/simon/code.py

import asyncio
import random
import time

import supervisor
from terminalio import FONT
from adafruit_display_text.label import Label
from displayio import Group
from displayio import OnDiskBitmap
from displayio import TileGrid


import badge.buttons
import badge.events as evt
from badge.buttons import any_button_downup
from badge.constants import BLACK
from badge.screens import EPD
from badge.screens import LCD
from badge.screens import round_button
from badge.screens import epd_print_exception
from badge.screens import center_text_x_plane
from badge.screens import center_text_y_plane
from badge.screens import wrap_message
from badge.screens import set_background
from badge.events import on
from badge.log import dbg
from badge.neopixels import neopixels_off, set_neopixel
from leaderboard import post_to_leaderboard

DEBUG = False

SPLASH_IMAGE = '/apps/simon/splash.bmp'

RED = (255,0,0)
YELLOW = (255,255,0)
GREEN = (0,255,0)
BLUE = (0,0,255)


#--- indicators when button press
@on(evt.BTN_A_PRESSED)
def on_a_pressed(e):
    set_neopixel("a", RED)

@on(evt.BTN_A_RELEASED)
def on_a_released(e):
    set_neopixel("a", 0)

@on(evt.BTN_B_PRESSED)
def on_b_pressed(e):
    set_neopixel("b", YELLOW)

@on(evt.BTN_B_RELEASED)
def on_b_released(e):
    set_neopixel("b", 0)

@on(evt.BTN_C_PRESSED)
def on_c_pressed(e):
    set_neopixel("c", GREEN)

@on(evt.BTN_C_RELEASED)
def on_c_released(e):
    set_neopixel("c", 0)

@on(evt.BTN_D_PRESSED)
def on_d_pressed(e):
    set_neopixel("d", BLUE)

@on(evt.BTN_D_RELEASED)
def on_a_released(e):
    set_neopixel("d", 0)

def button_row():
    splash = Group()
    radius = 5
    QUIT='Quit'
    AGAIN = 'Again'
    quit_lb = Label(font=FONT, text=QUIT)
    again_lb = Label(font=FONT, text=AGAIN)
    quit_bt = round_button(quit_lb, 5 + radius, EPD.height - 5 - radius - (quit_lb.height//2), radius)
    again_bt = round_button(again_lb, EPD.width - 5 - radius - again_lb.width, EPD.height - 5 - radius - (again_lb.height//2), radius)
    splash.append(quit_bt)
    splash.append(again_bt)
    EPD.root_group.append(splash)

def welcome_screen():
    set_background(EPD, BLACK)
    splash = Group()

    try:
        bmp = OnDiskBitmap(SPLASH_IMAGE)
    except OSError:
        # No art on the badge: fall back to the original text screen.
        splash.append(center_text_x_plane(EPD, "It's not Simon!"))
        splash.append(
            center_text_y_plane(EPD,
            center_text_x_plane(EPD,
            wrap_message(EPD, "[ PRESS ANY BUTTON TO START ]")
        )))
    else:
        splash.append(TileGrid(bmp, pixel_shader=bmp.pixel_shader))

    EPD.root_group.append(splash)
    EPD.refresh()

def score_screen(score):
    set_background(EPD, BLACK)
    score_title_lb = Label(font=FONT, text='Score:', x=2, y=(FONT.bitmap.height//2) + 2, scale=2)
    score_lb = center_text_y_plane(EPD, center_text_x_plane(EPD, f"{score}", scale=4))
    EPD.root_group.append(score_title_lb)
    EPD.root_group.append(score_lb)
    button_row()
    EPD.refresh()

    # A failed upload should not end the game. post_to_leaderboard() also draws
    # its own prompt/status on the LCD and never puts back what was there, so
    # stash and restore it (try/finally, since the failure case matters most).
    lcd_before = LCD.root_group
    try:
        post_to_leaderboard(score)
    except Exception as e:
        print("simon: leaderboard post failed:", e)
    finally:
        LCD.root_group = lcd_before

    neopixels_off()

    return None


# do blocking so no button presses
def show_pattern(pattern):
    pattern_len = len(pattern)
    on_delay = 1.0 - min(pattern_len*0.1, 0.65)
    off_delay = 1.0 - min(pattern_len*0.1, 0.9)
    str_to_color = {
        "a" : RED, "b" : YELLOW, "c" : GREEN, "d": BLUE
    }
    for c in pattern:
        set_neopixel(c, str_to_color[c])
        time.sleep(on_delay) # block
        neopixels_off()
        time.sleep(off_delay)

# convert button event to string to compare to pattern
def evt_to_str(e):
    d = { evt.BTN_A_DOWNUP : "a",
         evt.BTN_B_DOWNUP : "b",
         evt.BTN_C_DOWNUP : "c",
         evt.BTN_D_DOWNUP : "d"
    }
    return d.get(e, "never_match")


async def play_game(length):
    func = "play_game"
    DEBUG and dbg(func, "length=", length)
    pattern = [ random.choice(["a","b","c","d"]) for _ in range(length) ]
    DEBUG and dbg(func, "pattern=", pattern)
    show_pattern(pattern)
    time.sleep(0.25)
    for c in pattern:
        e = await any_button_downup()
        e_str = evt_to_str(e)
        DEBUG and dbg(func,"e_str=",e_str)
        if e_str != c:
            return False # failed
    return True # won

async def goto_fail(score):
    func = "goto_fail"
    score_screen(score)
    e = await evt.any_event([evt.BTN_A_DOWNUP, evt.BTN_D_DOWNUP])
    DEBUG and dbg(func, "e=", e)
    if e == evt.BTN_A_DOWNUP:
        supervisor.reload()
    if e == evt.BTN_D_DOWNUP:
        time.sleep(1)
        return

async def mainloop():
    func = "mainloop"
    DEBUG and dbg(func,"start")
    welcome_screen()
    pattern_length = 0
    won = True
    DEBUG and dbg(func,"await downup")
    await any_button_downup()
    while True:
        neopixels_off()
        time.sleep(2)
        if not won:
            await goto_fail(pattern_length)
            pattern_length = 0
        pattern_length += 1
        DEBUG and dbg(func, "pattern_length", pattern_length)
        won = await play_game(pattern_length)
        DEBUG and dbg(func, "won=", won)


async def main():
    # info_task = asyncio.create_task(info(interval=5.0))
    button_tasks = badge.buttons.all_tasks(interval=0.1)
    evt_tasks = evt.start_tasks()
    mainloop_task = asyncio.create_task(mainloop())
    # all_tasks = [ info_task, mainloop_task ] + button_tasks
    all_tasks = [ mainloop_task ] + button_tasks + evt_tasks
    await asyncio.gather(*all_tasks)

def run():
    asyncio.run(main())

if __name__ == "__main__":
    DEBUG and dbg(f"{__file__}", "__name__ == '__main__'")
    try:
        run()
    except Exception as e:
        epd_print_exception(e)
        time.sleep(60)
